chrischarltoncz/BioE-Zebrafish-automated-breeding-tank/(commit log)

2025-11-07 Fixed and features
    * NEW IN v4.1:
    * - FIXED: Timer state now preserved when Secondary is in deep sleep
    * - FIXED: Tanks with active timers no longer marked as "Disconnected"
    * - FIXED: Web interface shows accurate timer status throughout sleep period
    * - FIXED: Connection timeout skips tanks with active timers (expected to be asleep)
    * - FIXED: Timer tracking starts before sending command to prevent race condition
    * - FIXED: Added grace period after timer expiry to wait for Secondary confirmation
    *
    * NEW IN v4.0:
    * - FIXED: Removed duplicate esp_now_init() call
    * - FIXED: Removed unused fish bitmap (saved 264 bytes PROGMEM)
    * - FIXED: Sleep-after-opening now sends confi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
    [Primary_V4.1.ino]
2025-12-09 updates
    PWM motor control, sleep functions etc
2026-02-10 features
    Clock time slack plus battery percentage
2026-02-12 Sleep after open fix
    [Secondary_V4.6.ino]
2026-03-18 Fix battery % error
    Older versions above v4.6 would slack 0% battery when it was not, V5.1 fixes this
2026-04-02 Add files via upload
    Fix small bug where ESP-NOW stopped the ADC reading correctly so would display 0% battery when the tanks were connected
    [Secondary_V5.1.1.ino]
2026-07-14 Small adjustment
    This version of 5.1.1 removes the need to manually set the motor PWM for each tank motor. It uses the tank ID value to lookup the appropriate PWM value for each tank.
